bar4nka-pro/stm32-fso-laser-link/receiver/Core/Src/main.c

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
/* Includes ------------------------------------------------------------------*/
#include "main.h"
#include "usb_device.h"
/* USER CODE BEGIN Includes */
#include "laser_proto.h"
/* USER CODE END Includes */

/* USER CODE BEGIN PTD */
typedef struct
{
  uint8_t buffer[MAX_PAYLOAD];
  uint8_t length;
} packet_t;
/* USER CODE END PTD */

/* USER CODE BEGIN PD */
#define QUEUE_SIZE 8
/* USER CODE END PD */

UART_HandleTypeDef huart1;

void SystemClock_Config(void);
static void MX_GPIO_Init(void);
static void MX_USART1_UART_Init(void);
/* USER CODE BEGIN 0 */
#include "usbd_cdc_if.h"

volatile packet_t queue[QUEUE_SIZE];
volatile uint8_t head = 0;
volatile uint8_t tail = 0;
volatile uint32_t lost_counter = 0;

static parser_t rx_parser;
uint8_t rx_byte = 0;

volatile uint32_t fe_counter = 0;
volatile uint32_t ne_counter = 0;
volatile uint32_t ore_counter = 0;

//UART ERRORS COUNTER

static void count_uart_errors(uint32_t err)
{
  if (err & HAL_UART_ERROR_FE)
  {
    fe_counter++;
  }
  if (err & HAL_UART_ERROR_NE)
  {
    ne_counter++;
  }
  if (err & HAL_UART_ERROR_ORE)
  {
    ore_counter++;
  }
}

//UART INTERRUPT HANDLE

void HAL_UART_RxCpltCallback(UART_HandleTypeDef *huart) {
    if (huart->Instance == USART1)
    {
      count_uart_errors(huart->ErrorCode);
      if (feed_byte(&rx_parser, rx_byte, HAL_GetTick()) == PACKET) {
          uint8_t next = (head + 1) & (QUEUE_SIZE - 1);
          if (next == tail) {
          lost_counter++;
          }
          else {
            for (uint8_t i = 0; i < rx_parser.length; i++)
            {
              queue[head].buffer[i] = rx_parser.buffer[i];
            }
            queue[head].length = rx_parser.length;
            head = next;
          }
        }
      HAL_UART_Receive_IT(&huart1, &rx_byte, 1);
      }
    }

//UART ERROR INTERRUPT HANDLE

void HAL_UART_ErrorCallback(UART_HandleTypeDef *huart) {
  if (huart->Instance == USART1)
  {
    count_uart_errors(huart->ErrorCode);
    (void)HAL_UART_Receive_IT(&huart1, &rx_byte, 1);
  }
}
/* USER CODE END 0 */

/**
  * @brief  The application entry point.
  * @retval int
  */
int main(void)
{

  /* USER CODE BEGIN 1 */
static uint8_t output_buffer[MAX_PAYLOAD];
  static uint8_t output_length = 0;
  /* USER CODE END 1 */

  /* MCU Configuration--------------------------------------------------------*/

  /* Reset of all peripherals, Initializes the Flash interface and the Systick. */
  HAL_Init();

  /* Configure the system clock */
  SystemClock_Config();

  /* Initialize all configured peripherals */
  MX_GPIO_Init();
  MX_USART1_UART_Init();
  MX_USB_DEVICE_Init();
  /* USER CODE BEGIN 2 */
  parser_init(&rx_parser);
  // Включаем аппаратное прослушивание лазера (ждем 1 байт в фоне)
    HAL_UART_Receive_IT(&huart1, &rx_byte, 1);
  /* USER CODE END 2 */

  /* Infinite loop */
  /* USER CODE BEGIN WHILE */
  while (1)
  {
    /* USER CODE END WHILE */

    /* USER CODE BEGIN 3 */
	  if (head != tail) {
	    for (uint8_t i = 0; i < queue[tail].length; i++)
	    {
	      output_buffer[i] = queue[tail].buffer[i];
	    }
	    HAL_GPIO_WritePin(GPIOC, GPIO_PIN_13, GPIO_PIN_RESET);
	    output_length = queue[tail].length;
	    tail = (tail + 1) & (QUEUE_SIZE - 1);

	    uint8_t alert[] = "\r\n>> new message: ";
	    CDC_Transmit_FS(alert, sizeof(alert)-1);
	    HAL_Delay(5);

	    CDC_Transmit_FS(output_buffer, output_length);
	    HAL_Delay(5);
	    
	    uint8_t newline[] = "\r\n";
	    CDC_Transmit_FS(newline, sizeof(newline) - 1);
	    HAL_GPIO_WritePin(GPIOC, GPIO_PIN_13, GPIO_PIN_SET);
	    }
  /* USER CODE END 3 */
}
}

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
