bar4nka-pro/stm32-fso-laser-link/receiver/receiver.ioc

Mcu.UserName=STM32F411CEUx
PA10.Signal=USART1_RX
PA11.Signal=USB_OTG_FS_DM
PA12.Signal=USB_OTG_FS_DP
PA9.Signal=USART1_TX
PC13-ANTI_TAMP.Signal=GPIO_Output
