bar4nka-pro/stm32-fso-laser-link/(commit log)

2026-08-18 Drivers cleanup
2026-08-19 arm-none-eabi toolchain file for CMake
2026-08-31 UART parser now is external
2026-09-01 laser_proto into both modules added
2026-09-03 UART parser callback updated for new structure
2026-09-03 Updated Cmake for host-tests & board firmw build
2026-09-03 Add connection diagram to README
    Add connection diagram for STM32 transmitter and receiver.
2026-09-11 Fix dead PC13 LED on transmitter: enable GPIOC clock~
    [main.c]
2026-10-03 fixed length in transmitting new line in term on receiver-side; fixed silent error on term letting put more than 64 symbols on 1 message
    [main.c]
2026-10-05 new rx buffer logic
    [0] [1] [2] [3] [4] [5] [6] [7]
    ↑tail ↑head
    ┌─ очередь empty → buffer → main types in terminal
    message received ──┼─ queue is not empty → buffer → waits for its queue in main (lost before)
    └─ queue full → , lost_counter + 1 (lost)
    there was a bug, where rx can receive new message after "new message" was typed in terminal,
    BUT before actually message typed in.
    now its running on tail-head run, where earlier message typed in terminal before next, in case that is typing message in that moment - new message will be saved in buffer, and will be sent ne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
    [main.c]
2026-10-05 oscilloscope with 'Hello World!' message (frame) sent; fixed PC13 LED on receiver - now blink on message processing and sending to terminal
    [main.c]
2026-10-10 add FIFO ring buffer module with unit tests
    lock-free single-producer/single-consumer byte queue (256 slots,
    255 usable) for passing USB CDC data from the IRQ to the main loop.
    Wired into both firmware images; unused code is dropped by
    --gc-sections until the transmitter starts calling it.
2026-10-11 new USB protocol in progress, in debug stage
2026-10-12 receiver: count USART1 FE/NE/ORE errors
    Errors are counted in RxCpltCallback before re-arming: HAL_UART_Receive_IT
    clears huart->ErrorCode, so HAL_UART_ErrorCallback sees 0 for non-blocking
    errors. ErrorCallback still counts and re-arms in case of a blocking abort.
    Fault injection (IRQs off ~25 ms after each printed message) showed ORE does
    not stop reception here: re-arm inside RxCplt clears the ORE bit before HAL
    checks it. Lost frames came from the parser trusting a corrupted LEN byte
    and swallowing following frames (up to 64 bytes).
    Beam, 1200 baud: 182/182 delivered, ORE 0, NE on ~76% of bytes.
2026-10-12 parser: drop stale partial frame after inter-byte timeout
    feed_byte() takes the current time (HAL_GetTick() on target, fake clock
    in tests). A partial frame is discarded when the gap since the previous
    byte exceeds INTERBYTE_TIMEOUT_MS (20 ms, > 2 byte times at 1200 baud).
    Unsigned subtraction keeps it correct across the 49.7-day tick wrap.
    Tests: 5 new timeout cases incl. exact-boundary and tick wraparound;
    mutations (> vs >=, naive wrap compare, removed reset) each killed by
    the predicted test.
    Stand, fault injection on: after a corrupted burst the parser held a
    bogus LEN=50 frame; the next message after a pause is now delivered
    immediately (previously lost until the bogus frame was fill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
