bar4nka-pro/stm32-fso-laser-link/(notices)

Notices in the files:
receiver/Core/Src/main.c:
Copyright (c) 2026 STMicroelectronics.
All rights reserved.
This software is licensed under terms that can be found in the LICENSE file
